alexandreberg/SAPM_Sensor_BluePill/Documentation/Power_Comsumption_Tests/Deep_Sleep_Tests_20250319_03.jpg

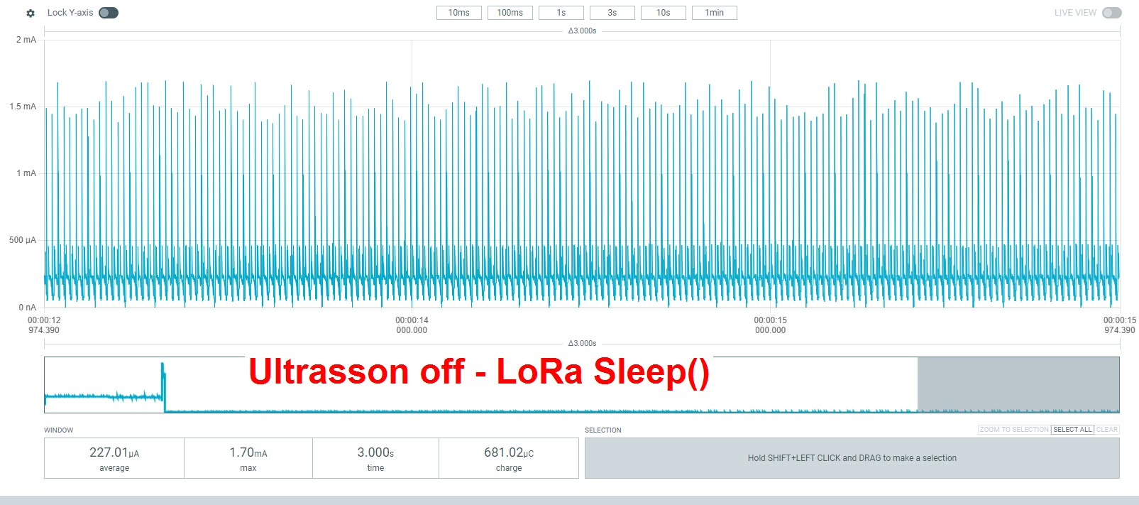
Documentation/Power_Comsumption_Tests/Deep_Sleep_Tests_20250319_03.jpg
