alexandreberg/SAPM_Sensor_BluePill/Documentation/Pictures/SAPI_sensor_01/Sensor-01_on_bridge-02.PNG

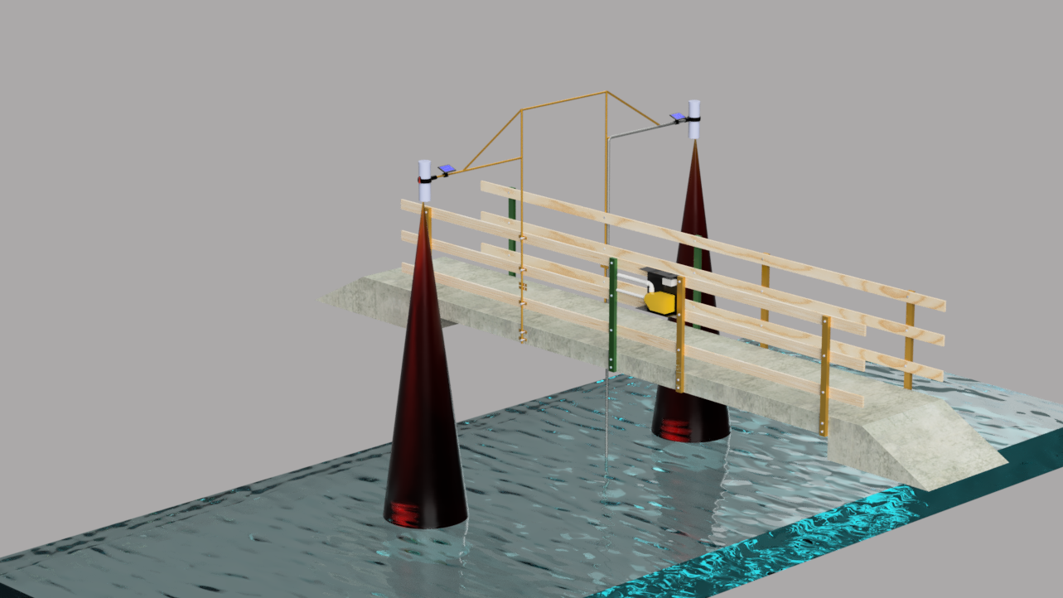
Documentation/Pictures/SAPI_sensor_01/Sensor-01_on_bridge-02.PNG
