alexandreberg/SAPM_Sensor_BluePill/README.md

# SAPM_Sensor_BluePill

> **⚠️ This repository has been migrated.**
> Production firmware for Station-01 is now maintained in the main SAPI repository:
> **[alexandreberg/SAPI_Sistema_de_Alerta_Previo_de_Inundacoes](https://github.com/alexandreberg/SAPI_Sistema_de_Alerta_Previo_de_Inundacoes)**
> under `App/stations/Rain_Gauge_Bluepill_estacao-01/`
>
> The active production branch here is `Station-01`. The latest deployed version is
> `SAPM_Sensor_BluePill_2026040701` — see the
> [v1.0.0 release](https://github.com/alexandreberg/SAPI_Sistema_de_Alerta_Previo_de_Inundacoes/releases/tag/station-01-v1.0.0)
> for the firmware binary.
This is a code for a flood alert system, FEWS (Flood Early Warning System) or in Portuguese SAPI (Sistema de Alerta Prévio de Inundações) the "M" in SAPM comes from de "Modular" version that will accept other types of sensors.
This version runs on STM32 BluePill.

It connects to a LoRa Gateway build with ESP32 **LILYGO-SIM7000G** wich code can be found [here:](https://github.com/alexandreberg/LILYGO-SIM7000G_LoRa_Gateway)

This is the code that is running in the Sensor-01 installed in the Bridge-02 in 01/01/2025.

The objective of this code is to generate data for the PCAM master thesis to have at least one year of data for analysis.

The code will be improved in the other sensors that will be installed.

## Folder structure:
```
C:.
├───Documentation                           // Documentation Folder
│   ├───Pictures                                    
│   │   └───SAPI_sensor_01                  // Pictures from the sensor PCB, case and fixing structure
│   └───Schematics
│       └───Transmissor_STM32_BluePill_V1   // Schematics of the board
├───src
PS C:\Projetos_GitHub\SAPM\SAPM_Sensor_BluePill>
```
