alexandreberg/SAPM_Sensor_BluePill/Documentation/CAD_Files/Sensor-01_on_bridge-02_02.png

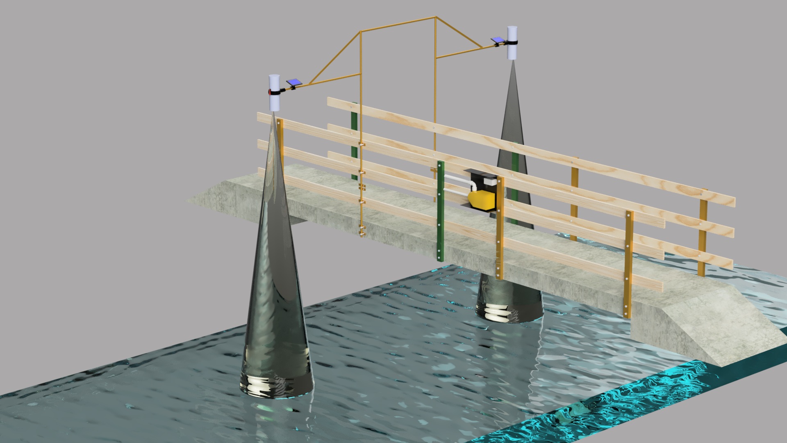
Documentation/CAD_Files/Sensor-01_on_bridge-02_02.png
