alexandreberg/SAPM_Sensor_BluePill/Documentation/Pictures/SAPI_sensor_01/Two_ultrasonic_sensors_conflict_error.png

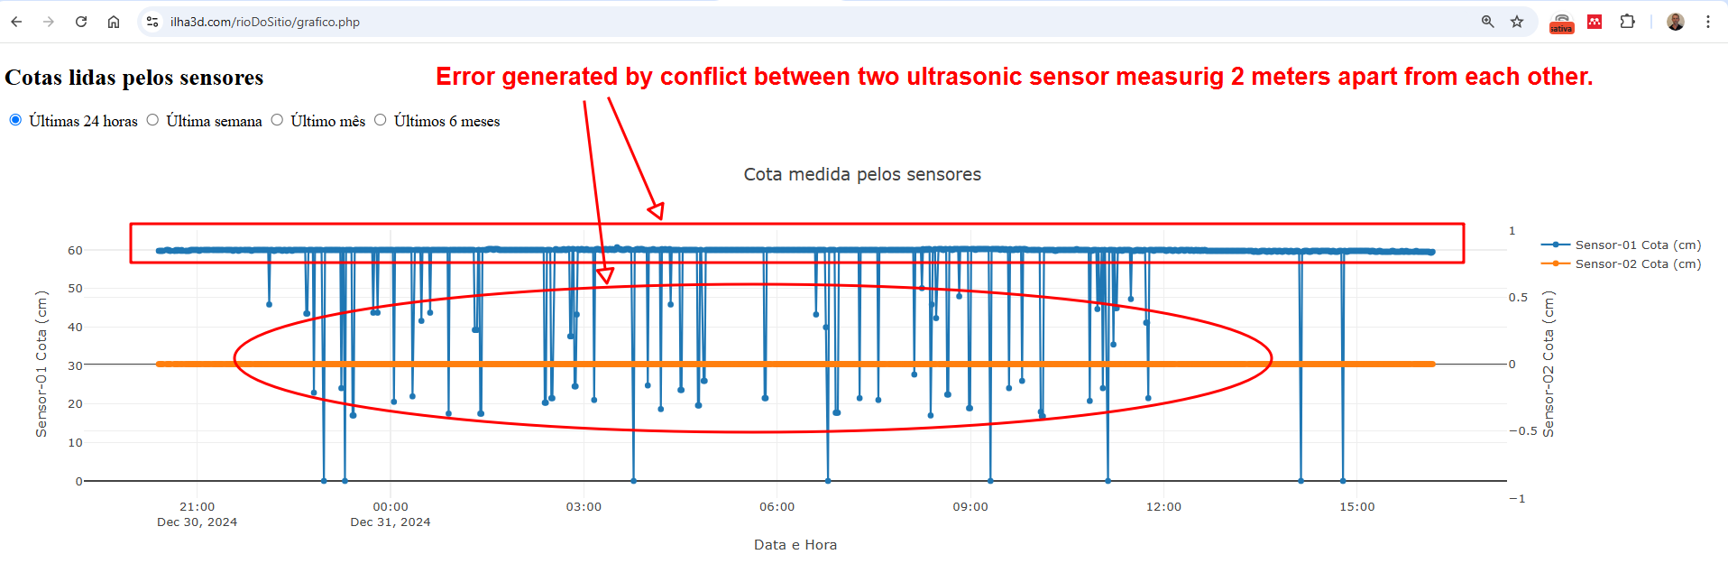
Documentation/Pictures/SAPI_sensor_01/Two_ultrasonic_sensors_conflict_error.png
