alexandreberg/SAPM_Sensor_BluePill/Documentation/Schematics/Transmissor_STM32_BluePill_V1/Transmissor_STM32_BluePill_V1.pdf

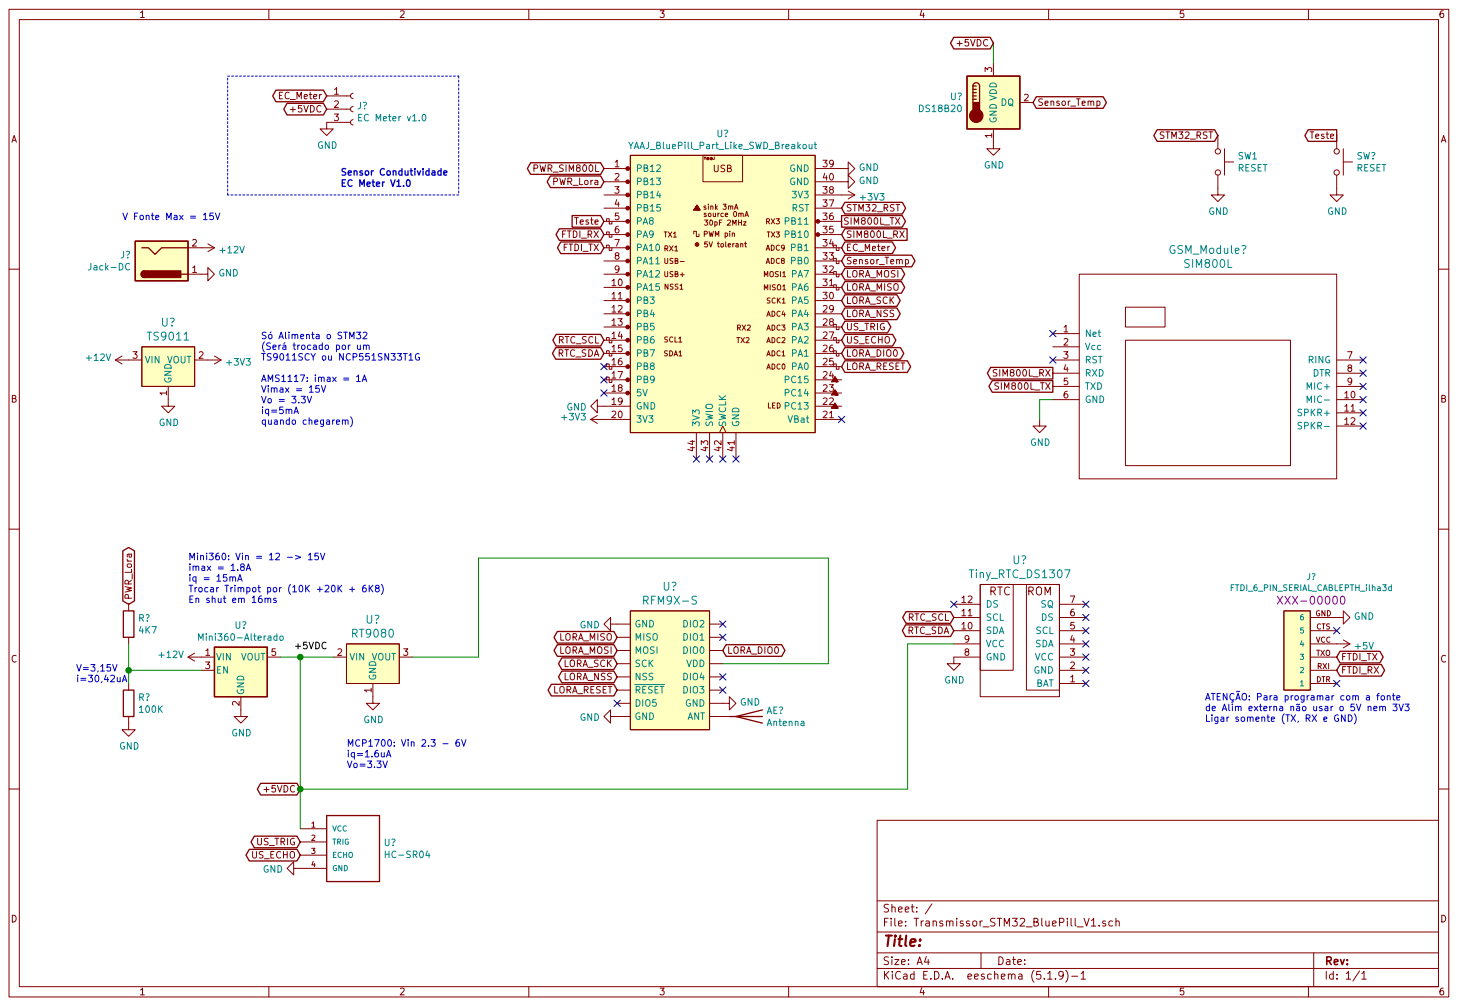
[picture p5: page 1]

Sensor Condutividade EC Meter V1.0 V=3,15V

quando chegarem) V Fonte Max = 15V

Ligar somente (TX, RX e GND) Só Alimenta o STM32
(Será trocado por um
TS9011SCY ou NCP551SN33T1G

2 EN 3 VOUT 5 U? Mini360-Alterado GND

ANT MISO MOSI SCK NSS RESET DIO5 GND

ATENÇÃO: Para programar com a fonte
de Alim externa não usar o 5V nem 3V3
