alexandreberg/SAPM_Sensor_BluePill/Documentation/Schematics/Transmissor_STM32_BluePill_V1/Trasmissor Rio do Peixe V1 - A3.pdf

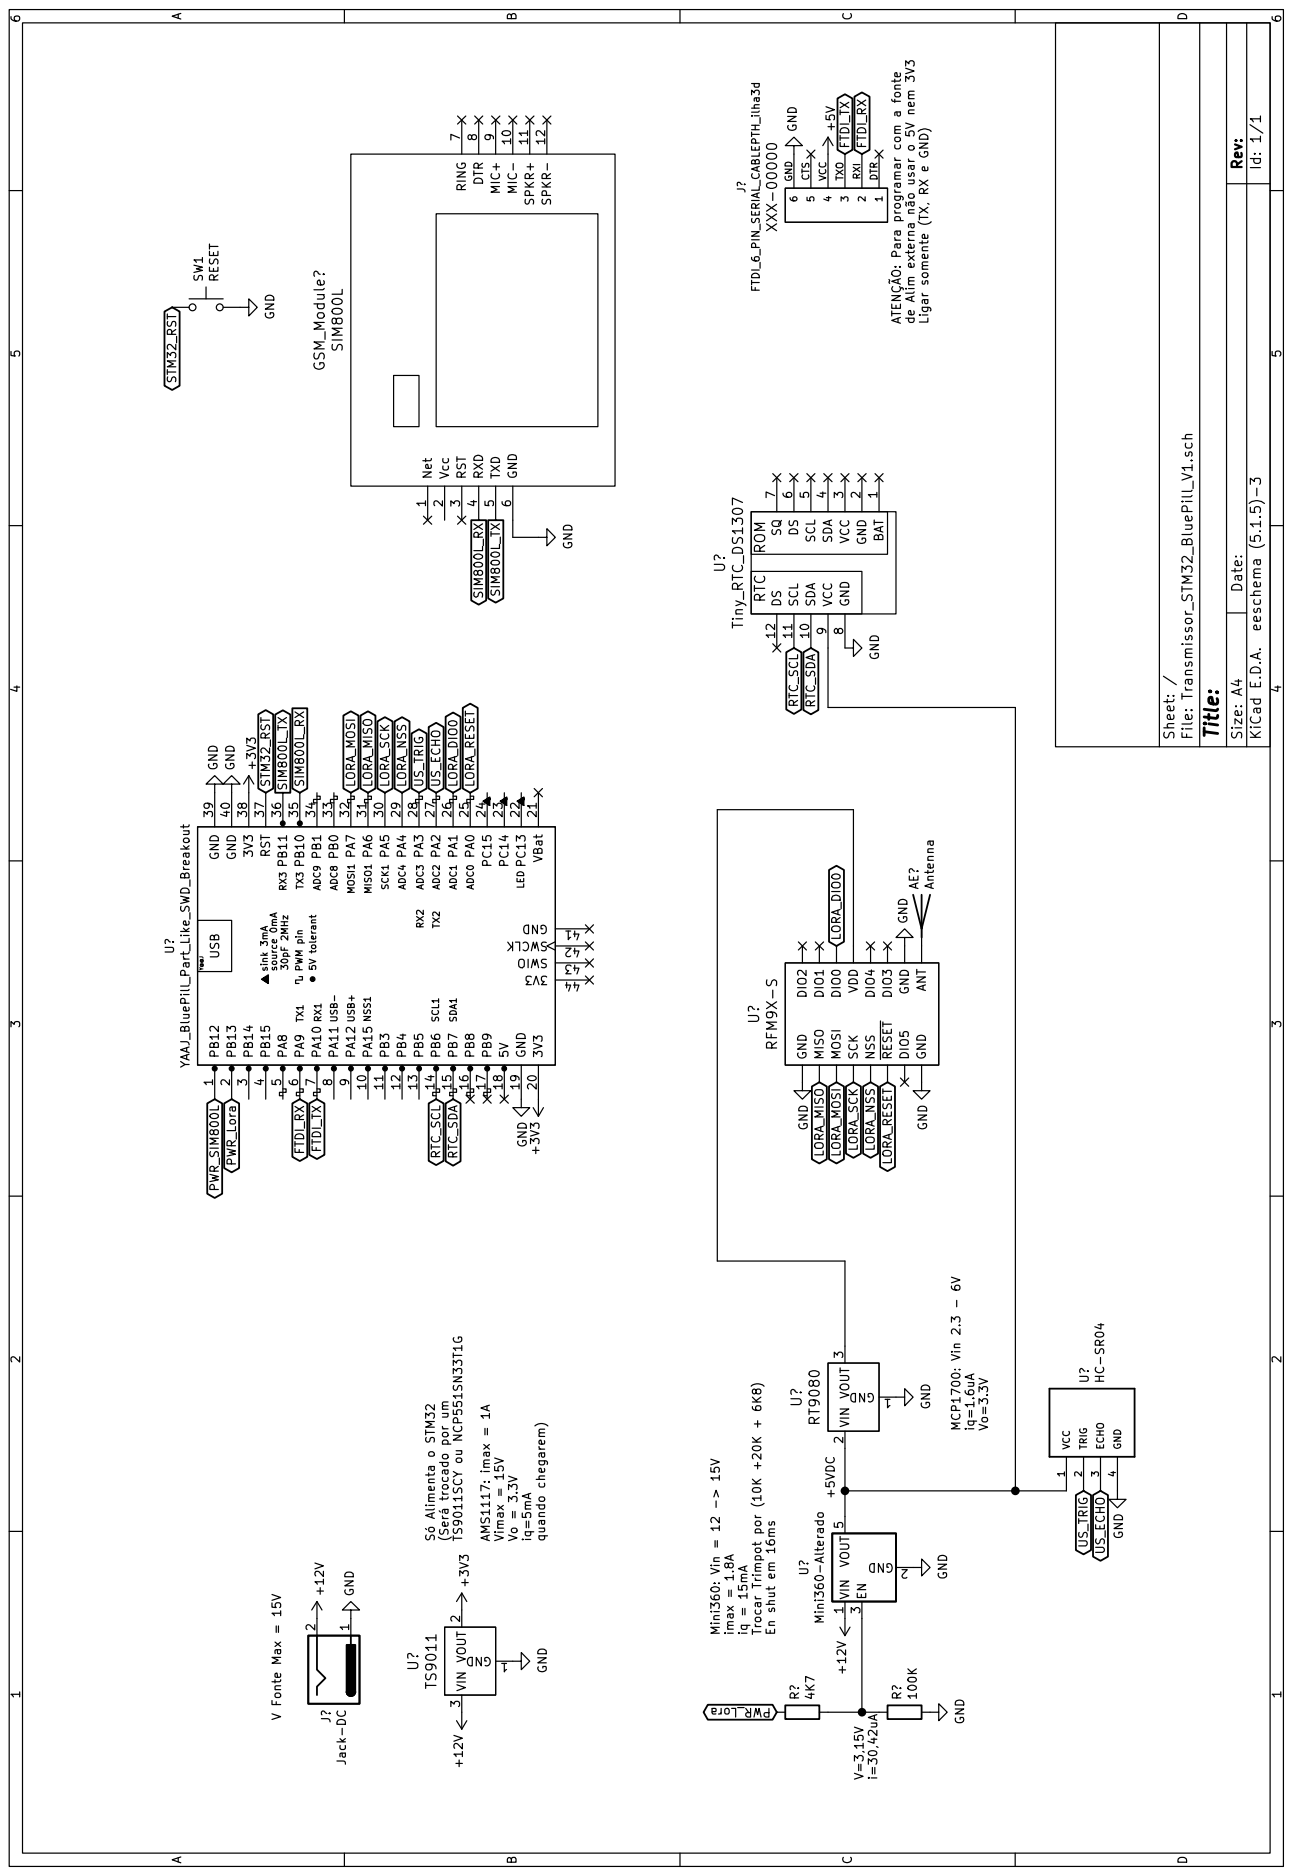
[picture p6: page 1]
