alexandreberg/SAPM_Sensor_BluePill/Documentation/Schematics/Transmissor_STM32_BluePill_V1/Transmissor_STM32_BluePill_V1.kicad_pcb

## KiCad design PCB/TempBug.sch


Parts:
BT1: Li-Ion; Pin_Header_Straight_1x02
C1, C2, C3: 100uF; C_Rect_L7_W4.5_P5
D1: LED_CHARGED; LED-5MM
D2: LED_CHARGING; LED-5MM
Q1, Q2: BS170; TO-92_Inline_Narrow_Oval
R1: 100k; Resistor_Horizontal_RM7mm
R2, R3: 150; Resistor_Horizontal_RM7mm
U1: MAX1555; SOT-23-5

Connections:
+5V: C1.1, C2.1, D1.2 (A), D2.2 (A), R1.1, U1.1 (USB), U1.4 (DC)
GND: BT1.2, C1.2, C2.2, C3.2, Q1.3 (S), Q2.3 (S), U1.2 (GND)
unnamed: BT1.1, C3.1, U1.5 (BAT)
unnamed: D1.1 (K), R2.1
unnamed: D2.1 (K), R3.1
unnamed: Q1.1 (D), Q2.2 (G), R2.2
unnamed: Q1.2 (G), R1.2, U1.3 (POK/CHG)
unnamed: Q2.1 (D), R3.2
