alexandreberg/SAPM_Sensor_BluePill/(commit log)

2024-12-28 Adjusted ultrasonic sensor variables
2024-12-29 Sensor-01 Test Version Installed in the Bridge-02
2024-12-29 Added Documentation folder
    [Transmissor_STM32_BluePill_V1.kicad_pcb, Transmissor_STM32_BluePill_V1.sch]
2024-12-30 Added CAD Fusuin360 Files
2025-02-09 Added configuration of sensor-01 from jan 2025
2025-02-19 Added production code for sensor-01 from jan/2025
2025-02-20 Fist power consumption test
2025-02-21 Video of 2nd power consumption test
2025-08-06 Added serial print to LoRa.setTxPower to 20dBm
2026-04-07 fix: assign median result to readingDistance before LoRa TX (fix #3)
    calculateMedian() was called but its return value was never written back
    to readingDistance, so every LoRa packet carried the last raw loop value
    instead of the filtered median. One-line fix ensures the median is what
    gets transmitted.
    Version bumped to SAPM_Sensor_BluePill_2026040701.
    Closes alexandreberg/SAPM_Sensor_BluePill#3
    [main.cpp]
